nenadalm/diy/raspicam/README.md

# Raspicam

* security camera saving video on motion using raspberry pi

## How to

* install lite image of [Raspberry Pi OS][10]
* login into raspbian using default username ```pi``` and  password ```raspberry```
    * run ```$ sudo raspi-config```
        * enable i2c: "Interfacing Options"/I2C/Yes
        * enable ssh: "Interfacing Options"/SSH/Yes
    * reboot ```$ sudo reboot```
    * update system
    ``` $ sudo apt update && sudo apt full-upgrade -y```
* use another pc to configure the pi
    * copy ssh-key into the camera
    ```
    $ ssh-copy-id pi@<pi_ip_addr>
    ```
    * ssh into pi and copy the public key to be able to login as root
        $ sudo cp -R .ssh /root
    * configure all your raspberry pis used as cam in ```/etc/ansible/hosts```
    ```
    [raspicams]
    <ip_of_the_pi> ansible_connection=ssh ansible_ssh_user=root
    ```
    * let ansible to configure the rest (the command also serves for updating to the latest version of raspicam)
    ```
    $ ansible-playbook ./ansible/playbook2.yml
    ```
* make ir-cut filter switcher (subdirectory ir-switcher)
* make case (subdirectory case)
* wire everything and put that into camera case
* turn raspberry pi on and run ansible

## Suggested SW
* [kicad][5]
    * you will need it to show electric circuits and make printed circuit boards
* [openscad][7]
    * you will need it to 3d print boxes and holders
* [slic3r][8]
    * you will need it to create gcode for your 3d printer

## Required HW
* [raspberry pi 2 model b][1] which will be used to control camera and take videos on motion
* wifi adapter to be able to connect to your raspberry wirelessly
* [pi noir camera][9] which allows you to take videos even at night
* [ir cut filter][2] which will improve quality of your videos during day filtering out infrared radiation
* additional components to make [ir cut filter][9] turn on/off automatically based on luminosity
    * [2x opto relay][3]
    * 2x npn transistor
    * 2x 470R resistor
    * 2x 100R resistor
    * [light sensor][4]

* 3d printer to print boxes and holders for components

[1]: http://www.raspberrypi.org/products/raspberry-pi-2-model-b/
[2]: http://www.ebay.com/itm/Good-IR-CUT-CS-0-3-Day-Night-Filter-Switcher-8-2mm-C-CS60-J-F-for-Net-Machine-/181634220091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
[3]: https://www.gme.cz/img/cache/doc/523/189/epr212a408000z-datasheet-1.pdf
[4]: http://www.easyduino.cz/Senzor-intenzity-osvetleni-pro-Arduino-BH1750FVI-GY-302-d126.ht
[5]: http://www.kicad-pcb.org/display/KICAD/KiCad+EDA+Software+Suite
[7]: http://www.openscad.org/
[8]: http://slic3r.org/
[9]: https://www.raspberrypi.org/products/pi-noir-camera/
[10]: https://www.raspberrypi.com/software/
