nenadalm/diy/raspicam/power-source/power_source-B_Cu.pdf

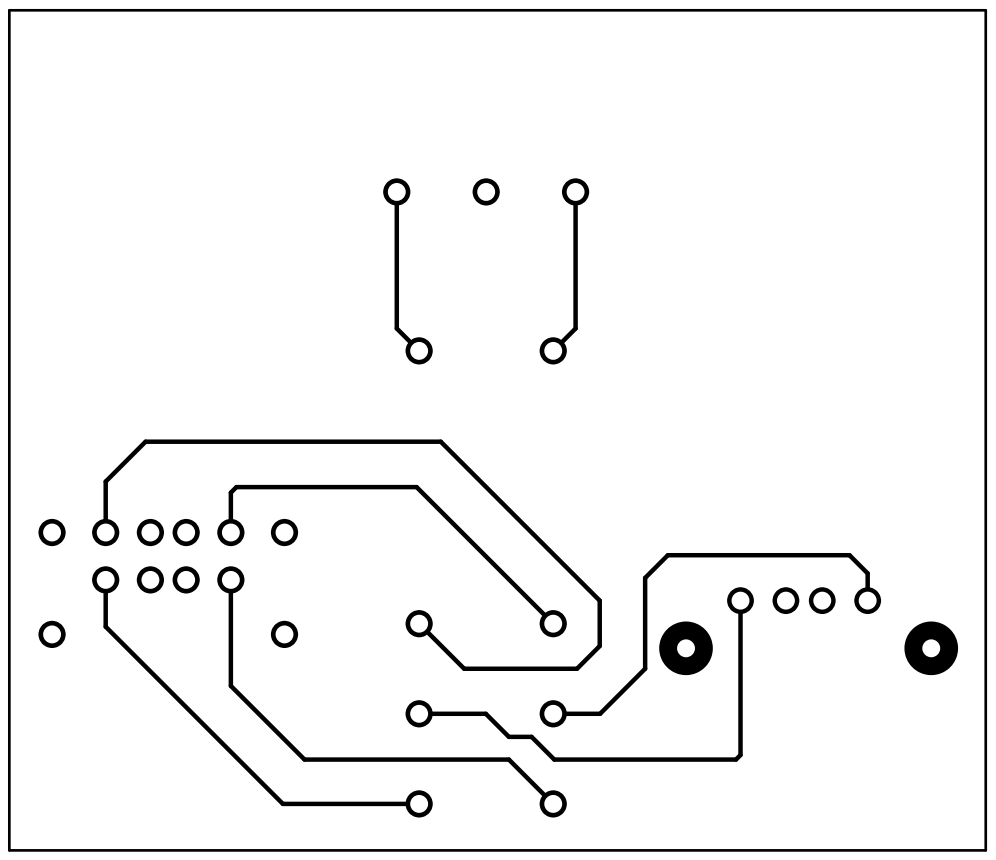
[picture p1: page 1]
