nenadalm/diy/raspicam/ir-switcher/ir-switcher.kicad_pcb

## KiCad design raspicam/ir-switcher/ir-switcher.kicad_pcb (2015-09-03)

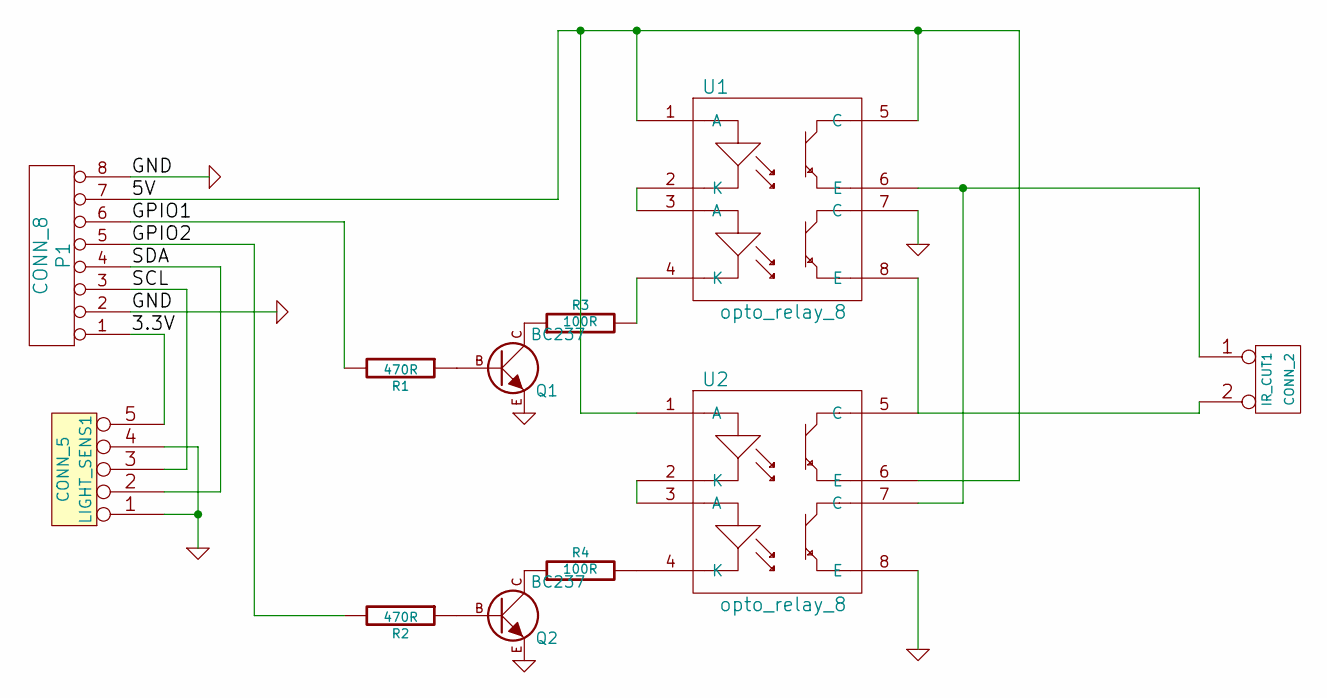
[picture p2: schematic ir-switcher.sch]

Parts:
IR_CUT1: CONN_2
LIGHT_SENS1: CONN_5
P1: CONN_8
Q1, Q2: BC237; TO92-EBC
R1, R2: 470R
R3, R4: 100R
U1, U2: opto_relay_8

Connections:
/3.3V: LIGHT_SENS1.5, P1.1
/5V: P1.7, U1.1 (A), U1.5 (C), U2.1 (A), U2.6 (E)
/GPIO1: P1.6, R1.2
/GPIO2: P1.5, R2.2
/SCL: LIGHT_SENS1.3, P1.3
/SDA: LIGHT_SENS1.2, P1.4
GND: LIGHT_SENS1.1, LIGHT_SENS1.4, P1.2, P1.8, Q1.E, Q2.E, U1.7 (C), U2.8 (E)
unnamed: IR_CUT1.1, U1.6 (E), U2.7 (C)
unnamed: IR_CUT1.2 (PM), U1.8 (E), U2.5 (C)
unnamed: Q1.B, R1.1
unnamed: Q1.C, R3.1
unnamed: Q2.B, R2.1
unnamed: Q2.C, R4.1
unnamed: R3.2, U1.4 (K)
unnamed: R4.2, U2.4 (K)
unnamed: U1.2 (K), U1.3 (A)
unnamed: U2.2 (K), U2.3 (A)

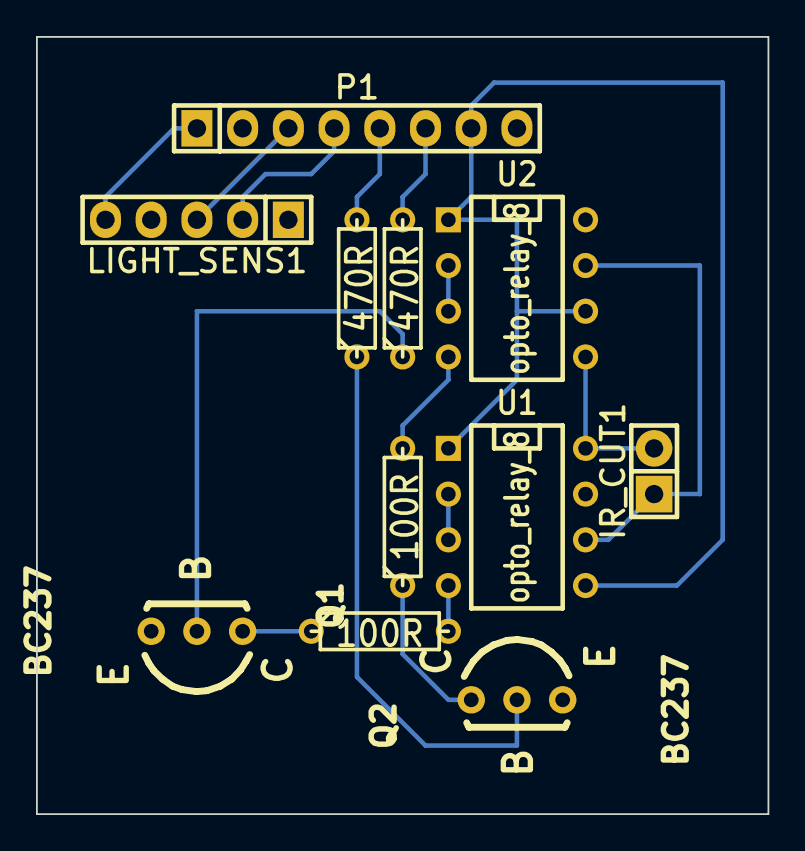
[picture p3: board ir-switcher.kicad_pcb from above]

Board: 2 copper layers, 40.6 x 43.2 mm, 11 parts (0 on the bottom side), 17 nets.
