nenadalm/diy/raspicam/power-source/power_source.kicad_pcb

## KiCad design raspicam/power-source/power_source.kicad_pcb (2015-09-03)

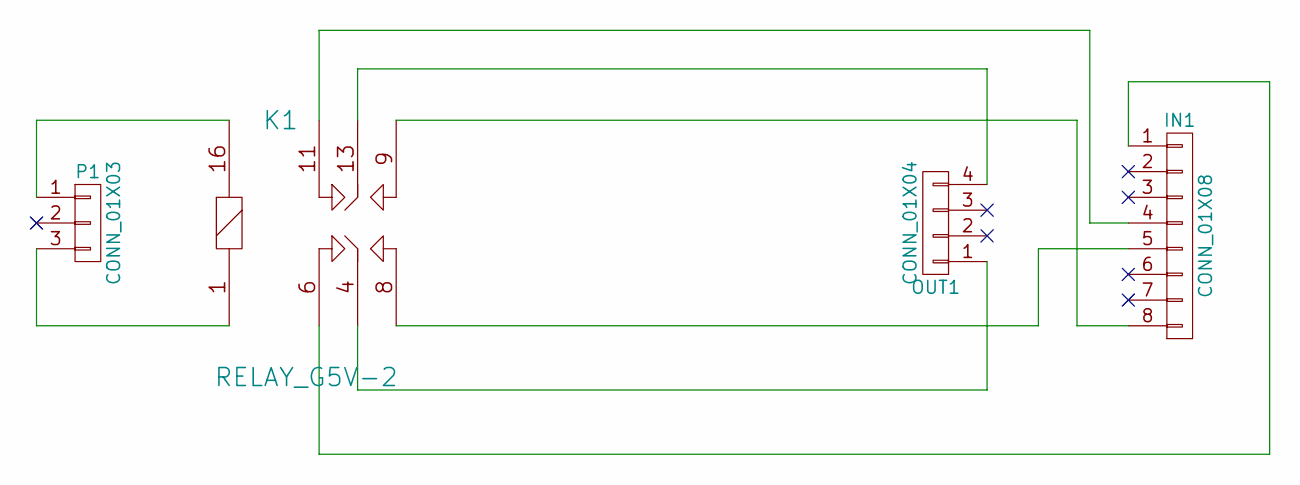
[picture p4: schematic power-source.sch]

Parts:
IN1: CONN_01X08; USB2AW
K1: RELAY_G5V-2; RELAY
OUT1: CONN_01X04; USB_A
P1: CONN_01X03; CMM_53SQ

Connections:
unnamed: IN1.1, K1.6
unnamed: IN1.4, K1.11
unnamed: IN1.5, K1.8
unnamed: IN1.8, K1.9
unnamed: K1.1, P1.3
unnamed: K1.4, OUT1.1
unnamed: K1.13, OUT1.4
unnamed: K1.16, P1.1

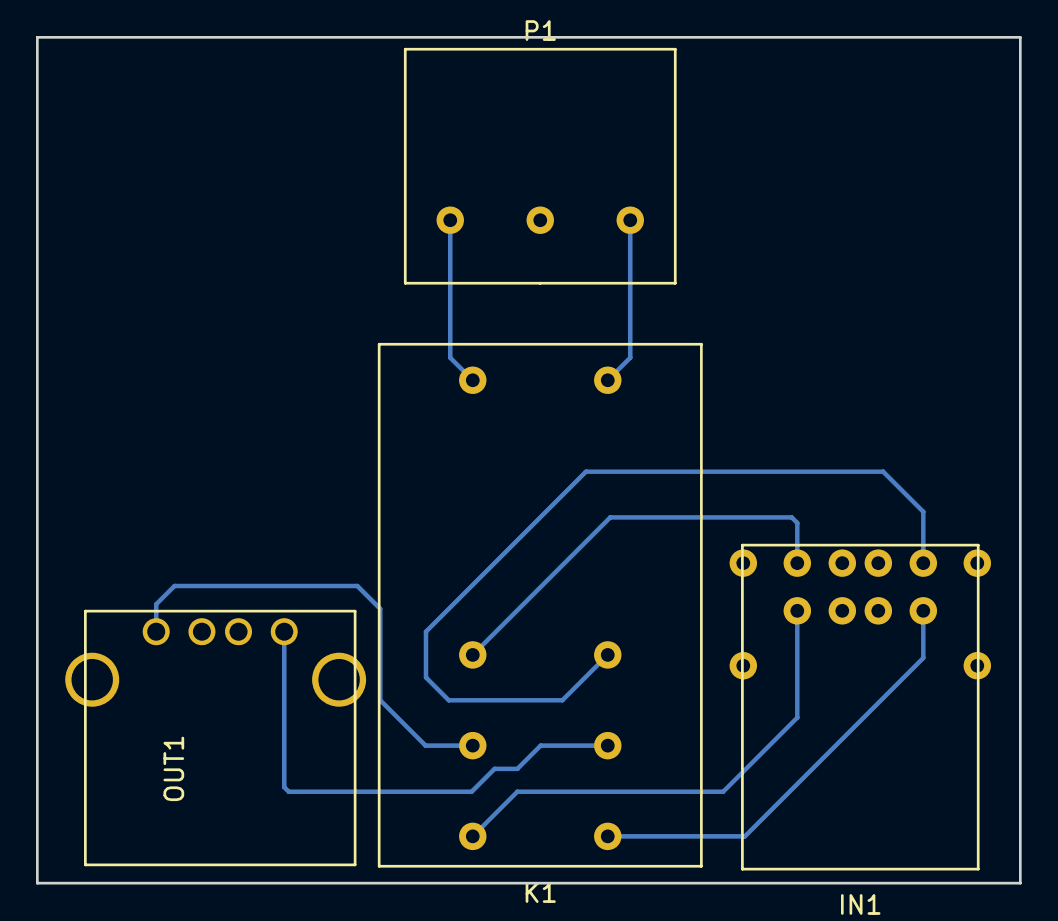
[picture p5: board power_source.kicad_pcb from above]

Board: 2 copper layers, 54.6 x 47.0 mm, 4 parts (0 on the bottom side), 8 nets.
