nenadalm/diy/(commit log)

2015-09-05 [Case]: Move holes higher so it's hopefully not necessary to use file
    [raspicam.scad]
2016-12-17 [raspicam]: Open in new version of KiCad
    [ir-switcher.sch]
2017-03-18 [raspicam]: Add ansible playbook, update readme
    [power-source.scad]
2024-09-01 [raspicam] Enable watchdog + forgotten systemed services, update mounts
2025-04-03 [raspicam] Add header into each h264 frame
